tejinc/FiberTest/documentations/photos/IMG_20201103_095938.jpg

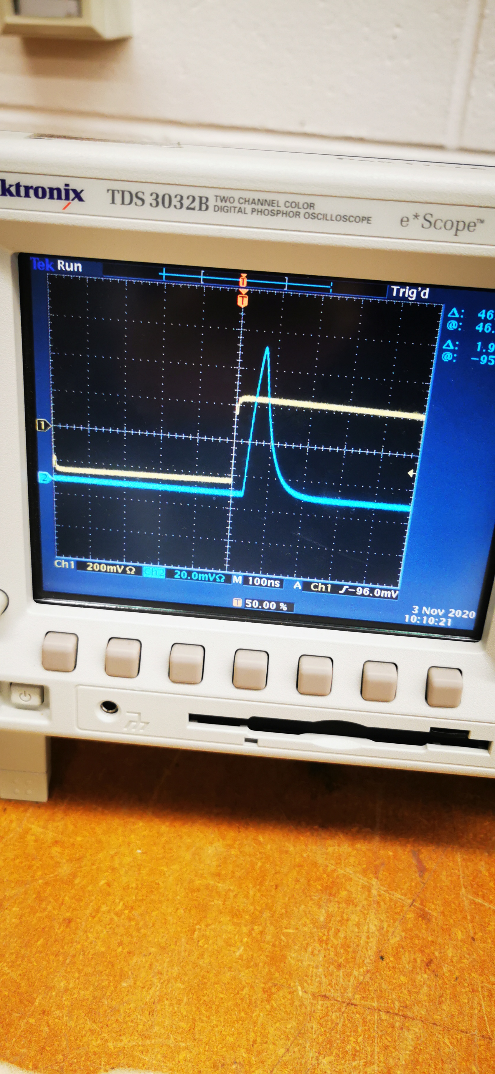
documentations/photos/IMG_20201103_095938.jpg
