tejinc/FiberTest/documentations/photos/IMG_20201105_115005.jpg

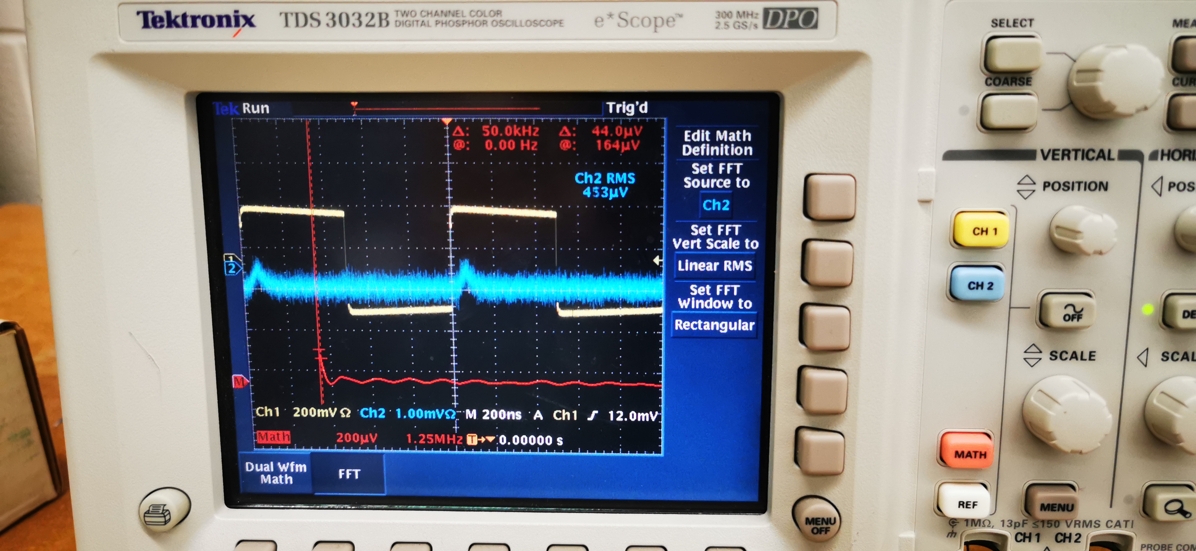
documentations/photos/IMG_20201105_115005.jpg
