tejinc/FiberTest/documentations/photos/IMG_20201101_124711.jpg

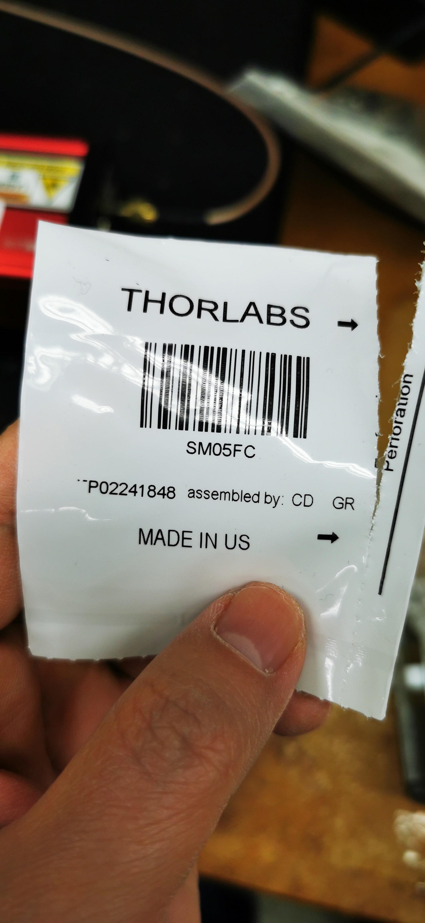
documentations/photos/IMG_20201101_124711.jpg
