tejinc/FiberTest/documentations/photos/IMG_20201103_100010.jpg

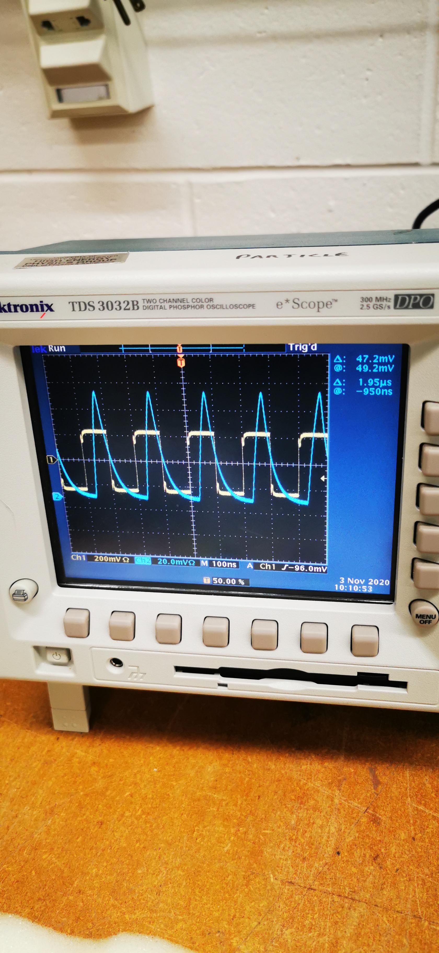
documentations/photos/IMG_20201103_100010.jpg
