tejinc/FiberTest/documentations/photos/IMG_20201103_192202.jpg

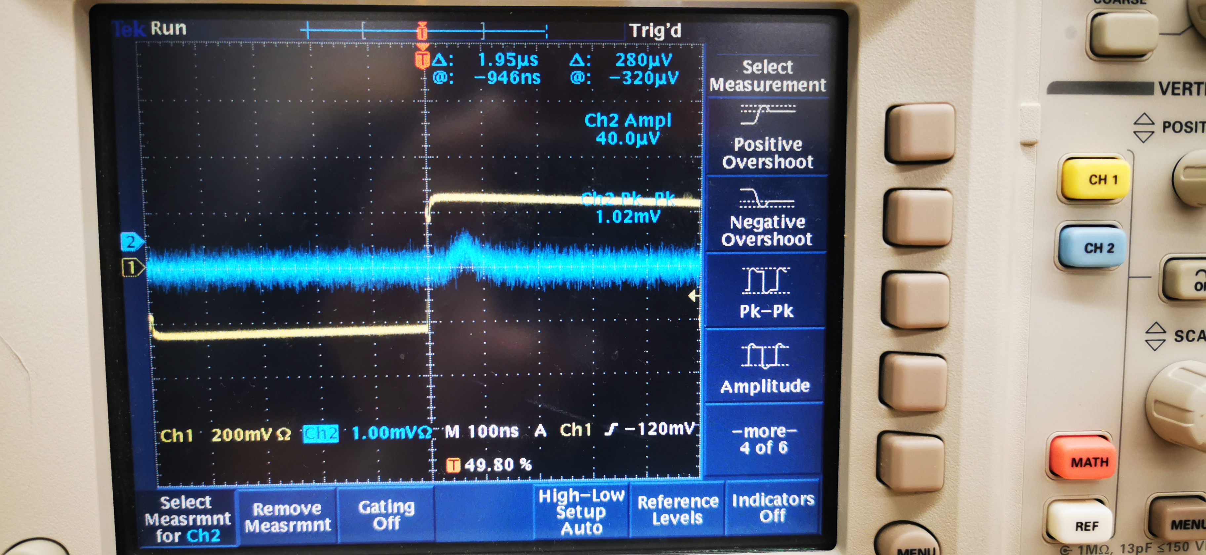
documentations/photos/IMG_20201103_192202.jpg
