tejinc/FiberTest/documentations/photos/IMG_20201103_193623.jpg

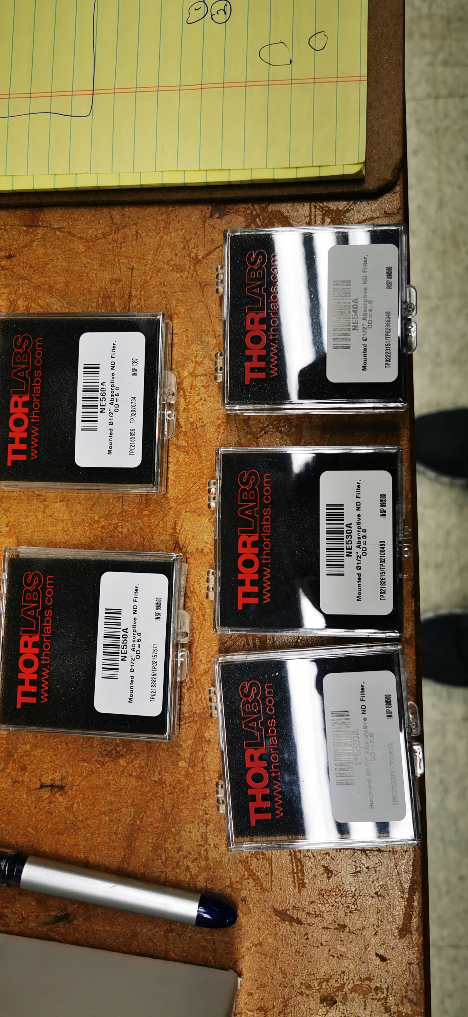
documentations/photos/IMG_20201103_193623.jpg
