tejinc/FiberTest/documentations/photos/IMG_20201105_132534.jpg

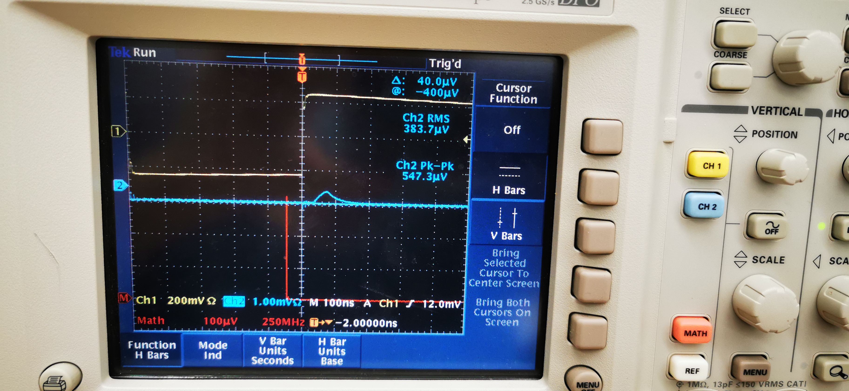
documentations/photos/IMG_20201105_132534.jpg
