tejinc/FiberTest/documentations/photos/IMG_20201105_132719.jpg

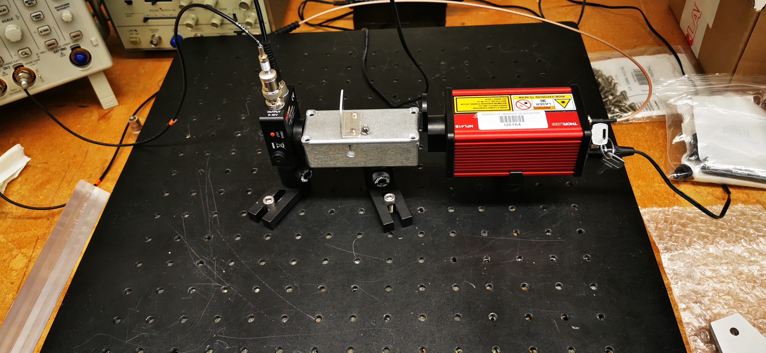
documentations/photos/IMG_20201105_132719.jpg
