tejinc/FiberTest/documentations/photos/IMG_20201105_132730.jpg

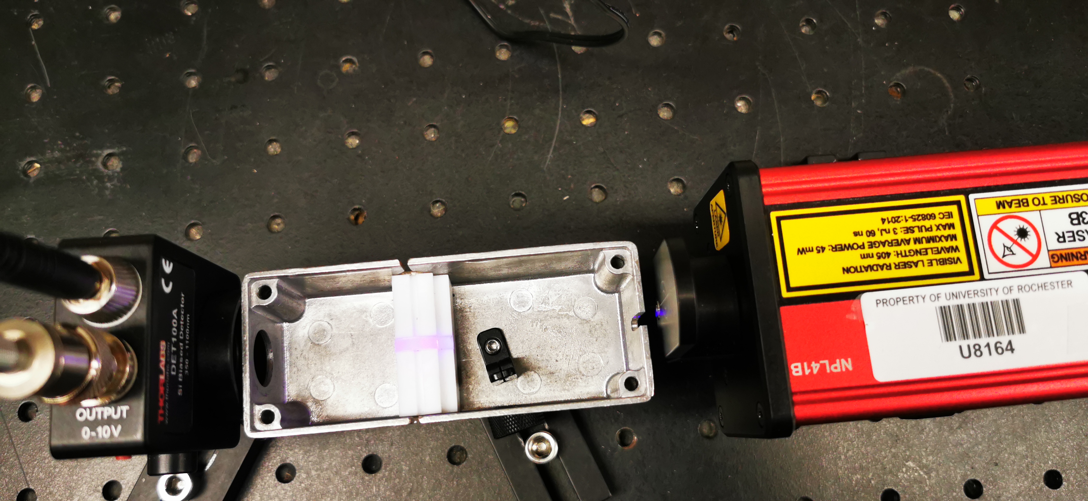
documentations/photos/IMG_20201105_132730.jpg
