tejinc/FiberTest/(commit log)

2021-06-23 added note about ND filter
2021-06-25 Arduino software, made by Dave Munson
